Nisha51/HiveKB_THT/HiveKB.kicad_pcb

## KiCad design HiveKB.kicad_pcb (2023-12-24)

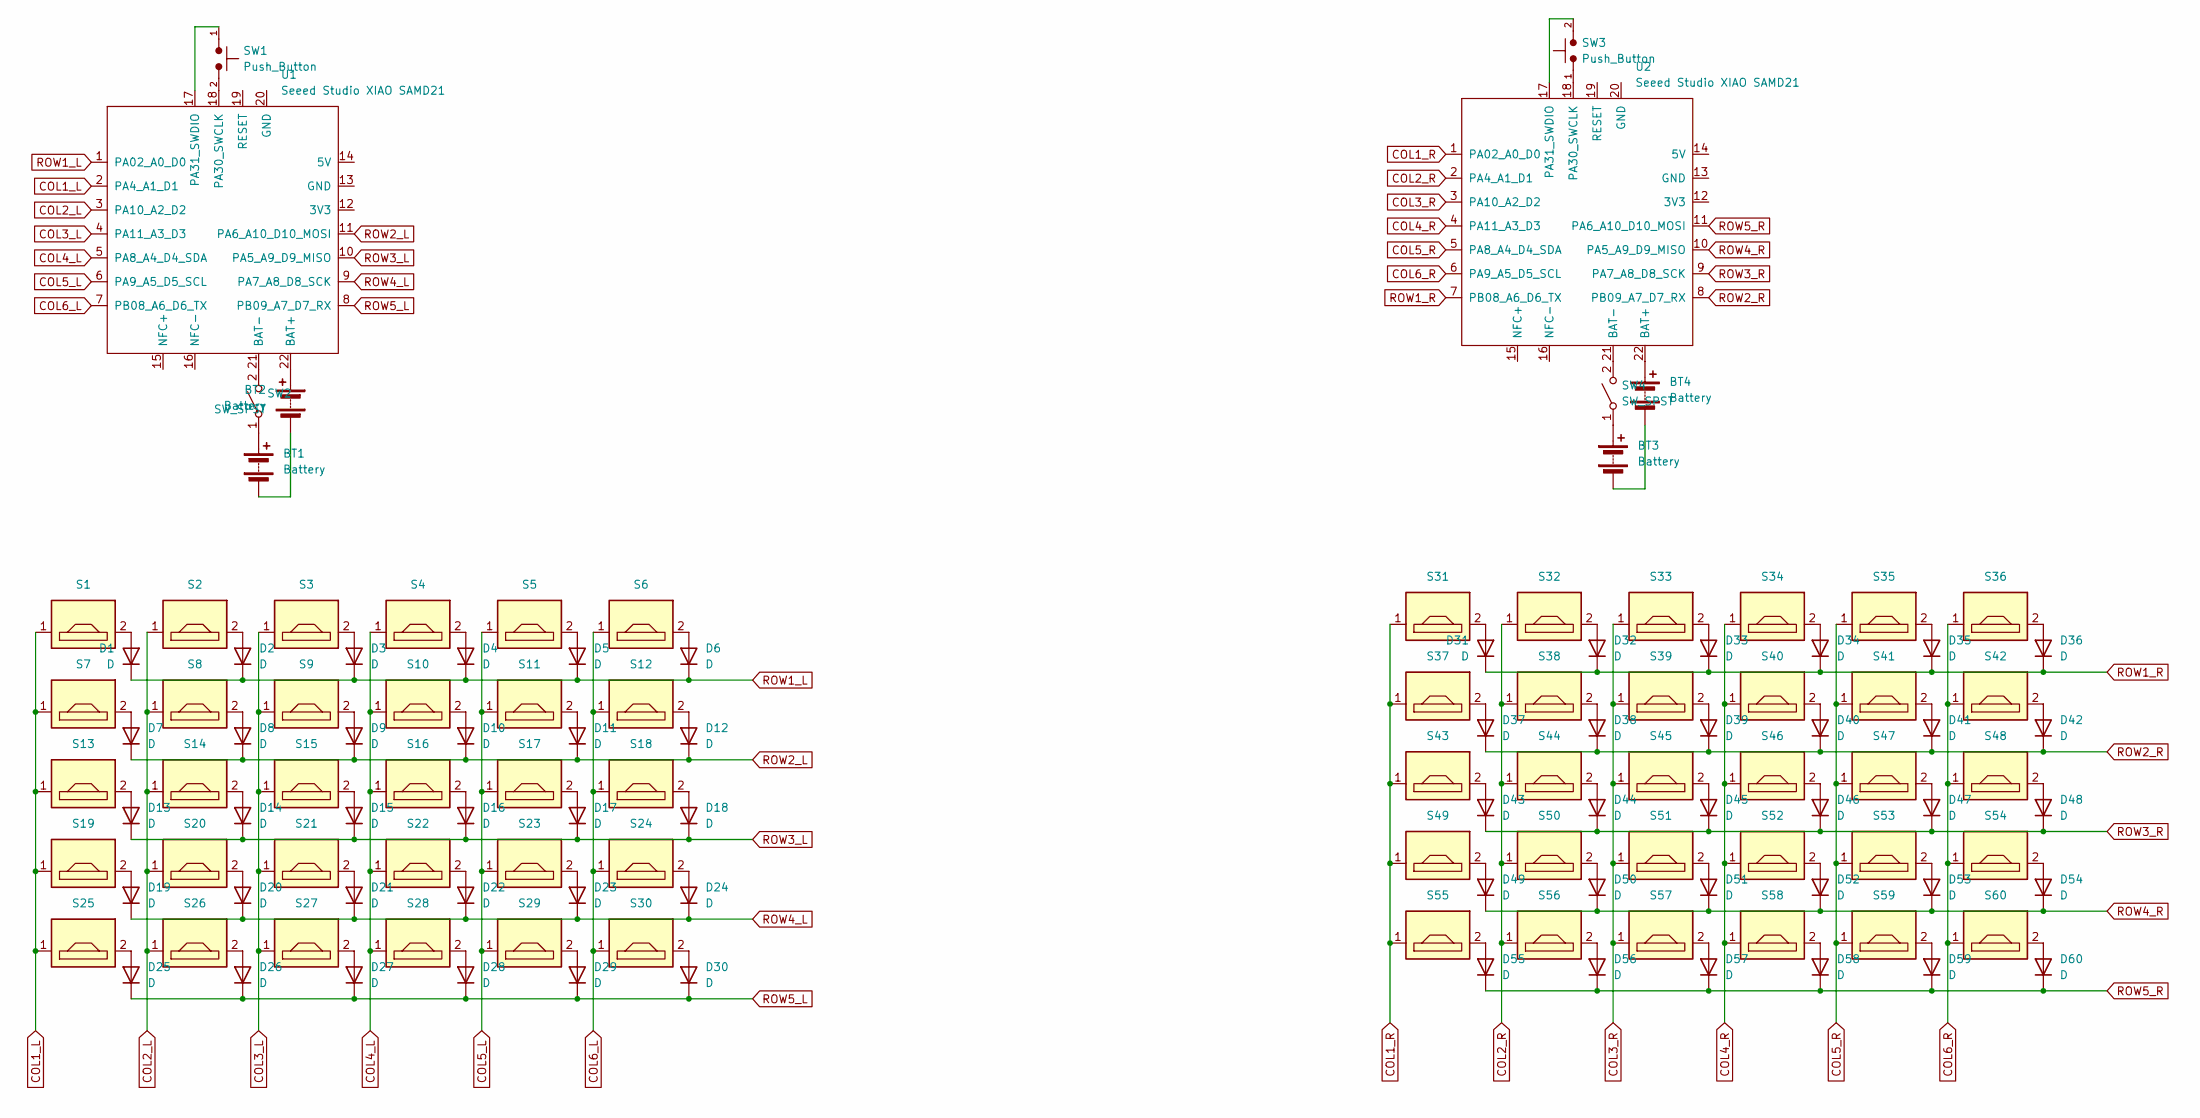
[picture p1: schematic HiveKB.kicad_sch, Hive]

Parts:
BT1, BT2, BT3, BT4: Battery; TestPoint_Keystone_5019_Minature
D1, D2, D3, D4, D5, D6, D7, D8, D9, D10, D11, D12, D13, D14, D15, D16, D17, D18, D19, D20, D21, D22, D23, D24, D25, D26, D27, D28, D29, D30, D31, D32, D33, D34, D35, D36, D37, D38, D39, D40, D41, D42, D43, D44, D45, D46, D47, D48, D49, D50, D51, D52, D53, D54, D55, D56, D57, D58, D59, D60: D; D_SOD-123
S1, S2, S3, S4, S5, S6, S7, S8, S9, S10, S11, S12, S13, S14, S15, S16, S17, S18, S19, S20, S21, S22, S23, S24, S25, S26, S27, S28, S29, S30, S31, S32, S33, S34, S35, S36, S37, S38, S39, S40, S41, S42, S43, S44, S45, S46, S47, S48, S49, S50, S51, S52, S53, S54, S55, S56, S57, S58, S59, S60: PG1350; PG1350_hotswap
SW1, SW3: Push_Button; Panasonic_EVQPUL_EVQPUC
SW2, SW4: SW_SPST; SW_SPDT_PCM12
U1, U2: Seeed Studio XIAO SAMD21; xiao-ble-smd-cutout

Connections:
COL1_L: S1.1, S7.1, S13.1, S19.1, S25.1, U1.2 (PA4_A1_D1)
COL1_R: S31.1, S37.1, S43.1, S49.1, S55.1, U2.1 (PA02_A0_D0)
COL2_L: S2.1, S8.1, S14.1, S20.1, S26.1, U1.3 (PA10_A2_D2)
COL2_R: S32.1, S38.1, S44.1, S50.1, S56.1, U2.2 (PA4_A1_D1)
COL3_L: S3.1, S9.1, S15.1, S21.1, S27.1, U1.4 (PA11_A3_D3)
COL3_R: S33.1, S39.1, S45.1, S51.1, S57.1, U2.3 (PA10_A2_D2)
COL4_L: S4.1, S10.1, S16.1, S22.1, S28.1, U1.5 (PA8_A4_D4_SDA)
COL4_R: S34.1, S40.1, S46.1, S52.1, S58.1, U2.4 (PA11_A3_D3)
COL5_L: S5.1, S11.1, S17.1, S23.1, S29.1, U1.6 (PA9_A5_D5_SCL)
COL5_R: S35.1, S41.1, S47.1, S53.1, S59.1, U2.5 (PA8_A4_D4_SDA)
COL6_L: S6.1, S12.1, S18.1, S24.1, S30.1, U1.7 (PB08_A6_D6_TX)
COL6_R: S36.1, S42.1, S48.1, S54.1, S60.1, U2.6 (PA9_A5_D5_SCL)
unnamed: BT1.1 (+), SW2.1 (A)
unnamed: BT2.1 (+), U1.22 (BAT+)
unnamed: BT3.1 (+), SW4.1 (A)
unnamed: BT4.1 (+), U2.22 (BAT+)
unnamed: D1.2 (A), S1.2
unnamed: D2.2 (A), S2.2
unnamed: D3.2 (A), S3.2
unnamed: D4.2 (A), S4.2
unnamed: D5.2 (A), S5.2
unnamed: D6.2 (A), S6.2
unnamed: D7.2 (A), S7.2
unnamed: D8.2 (A), S8.2
unnamed: D9.2 (A), S9.2
unnamed: D10.2 (A), S10.2
unnamed: D11.2 (A), S11.2
unnamed: D12.2 (A), S12.2
unnamed: D13.2 (A), S13.2
unnamed: D14.2 (A), S14.2
unnamed: D15.2 (A), S15.2
unnamed: D16.2 (A), S16.2
unnamed: D17.2 (A), S17.2
unnamed: D18.2 (A), S18.2
unnamed: D19.2 (A), S19.2
unnamed: D20.2 (A), S20.2
unnamed: D21.2 (A), S21.2
unnamed: D22.2 (A), S22.2
unnamed: D23.2 (A), S23.2
unnamed: D24.2 (A), S24.2
unnamed: D25.2 (A), S25.2
unnamed: D26.2 (A), S26.2
unnamed: D27.2 (A), S27.2
unnamed: D28.2 (A), S28.2
unnamed: D29.2 (A), S29.2
unnamed: D30.2 (A), S30.2
unnamed: D31.2 (A), S31.2
unnamed: D32.2 (A), S32.2
unnamed: D33.2 (A), S33.2
unnamed: D34.2 (A), S34.2
unnamed: D35.2 (A), S35.2
unnamed: D36.2 (A), S36.2
unnamed: D37.2 (A), S37.2
unnamed: D38.2 (A), S38.2
unnamed: D39.2 (A), S39.2
unnamed: D40.2 (A), S40.2
unnamed: D41.2 (A), S41.2
unnamed: D42.2 (A), S42.2
unnamed: D43.2 (A), S43.2
unnamed: D44.2 (A), S44.2
unnamed: D45.2 (A), S45.2
unnamed: D46.2 (A), S46.2
unnamed: D47.2 (A), S47.2
unnamed: D48.2 (A), S48.2
unnamed: D49.2 (A), S49.2
unnamed: D50.2 (A), S50.2
unnamed: D51.2 (A), S51.2
unnamed: D52.2 (A), S52.2
unnamed: D53.2 (A), S53.2
unnamed: D54.2 (A), S54.2
unnamed: D55.2 (A), S55.2
unnamed: D56.2 (A), S56.2
unnamed: D57.2 (A), S57.2
unnamed: D58.2 (A), S58.2
unnamed: D59.2 (A), S59.2
unnamed: D60.2 (A), S60.2
unnamed: SW2.2 (B), U1.21 (BAT-)
unnamed: SW4.2 (B), U2.21 (BAT-)
unnamed: SW1.2, U1.18 (PA30_SWCLK)
unnamed: SW1.1, U1.17 (PA31_SWDIO)
unnamed: SW3.1, U2.18 (PA30_SWCLK)
unnamed: SW3.2, U2.17 (PA31_SWDIO)
ROW1_L: D1.1 (K), D2.1 (K), D3.1 (K), D4.1 (K), D5.1 (K), D6.1 (K), U1.1 (PA02_A0_D0)
ROW1_R: D31.1 (K), D32.1 (K), D33.1 (K), D34.1 (K), D35.1 (K), D36.1 (K), U2.7 (PB08_A6_D6_TX)
ROW2_L: D7.1 (K), D8.1 (K), D9.1 (K), D10.1 (K), D11.1 (K), D12.1 (K), U1.11 (PA6_A10_D10_MOSI)
ROW2_R: D37.1 (K), D38.1 (K), D39.1 (K), D40.1 (K), D41.1 (K), D42.1 (K), U2.8 (PB09_A7_D7_RX)
ROW3_L: D13.1 (K), D14.1 (K), D15.1 (K), D16.1 (K), D17.1 (K), D18.1 (K), U1.10 (PA5_A9_D9_MISO)
ROW3_R: D43.1 (K), D44.1 (K), D45.1 (K), D46.1 (K), D47.1 (K), D48.1 (K), U2.9 (PA7_A8_D8_SCK)
ROW4_L: D19.1 (K), D20.1 (K), D21.1 (K), D22.1 (K), D23.1 (K), D24.1 (K), U1.9 (PA7_A8_D8_SCK)
ROW4_R: D49.1 (K), D50.1 (K), D51.1 (K), D52.1 (K), D53.1 (K), D54.1 (K), U2.10 (PA5_A9_D9_MISO)
ROW5_L: D25.1 (K), D26.1 (K), D27.1 (K), D28.1 (K), D29.1 (K), D30.1 (K), U1.8 (PB09_A7_D7_RX)
ROW5_R: D55.1 (K), D56.1 (K), D57.1 (K), D58.1 (K), D59.1 (K), D60.1 (K), U2.11 (PA6_A10_D10_MOSI)

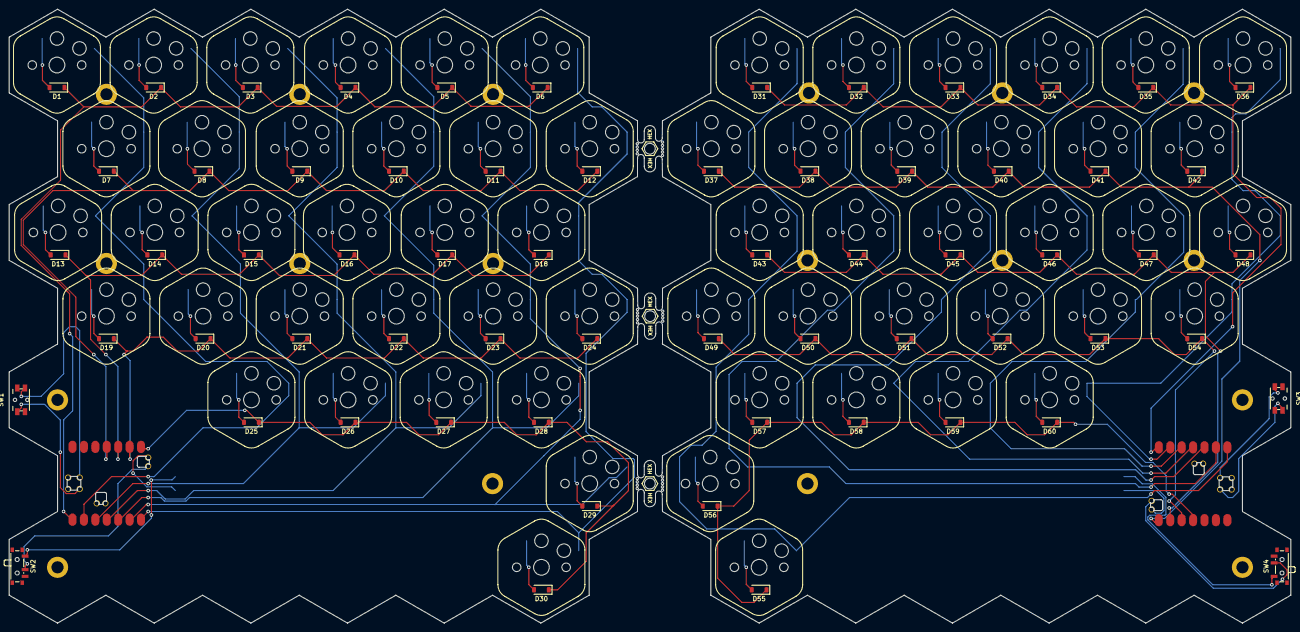
[picture p2: board HiveKB.kicad_pcb from above]

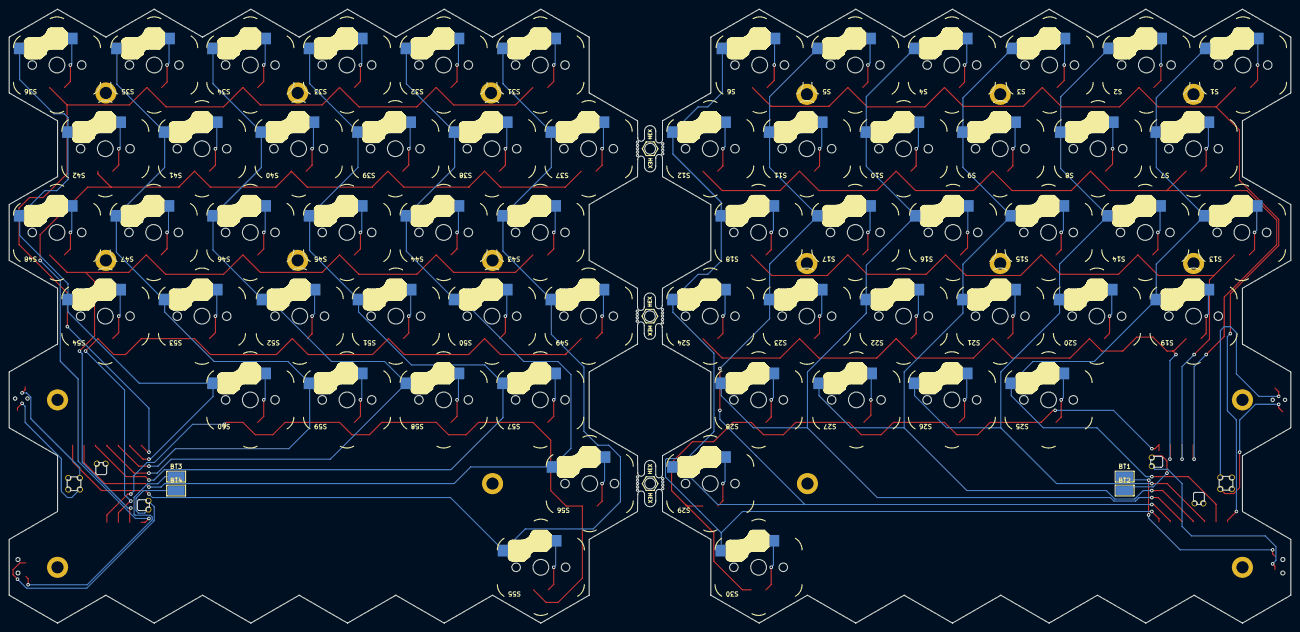
[picture p3: board HiveKB.kicad_pcb from below]

Board: 2 copper layers, 285.1 x 136.5 mm, 133 parts (64 on the bottom side), 92 nets.

Other parts of the board:
MB5, MB5#2, MB5#3: 5.5mm; mousebites_5p5mm_easysnap
